Elzee-Studios/WRO-2026-Future-Engineers/vehicle-photos/Left.jpg

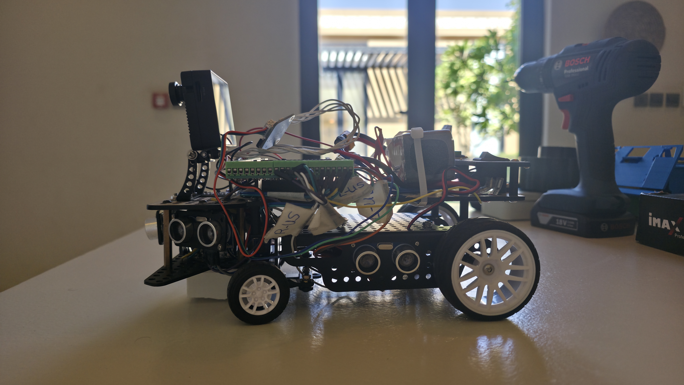
vehicle-photos/Left.jpg
