Elzee-Studios/WRO-2026-Future-Engineers/team-photos/Team-Photo-One.jpg

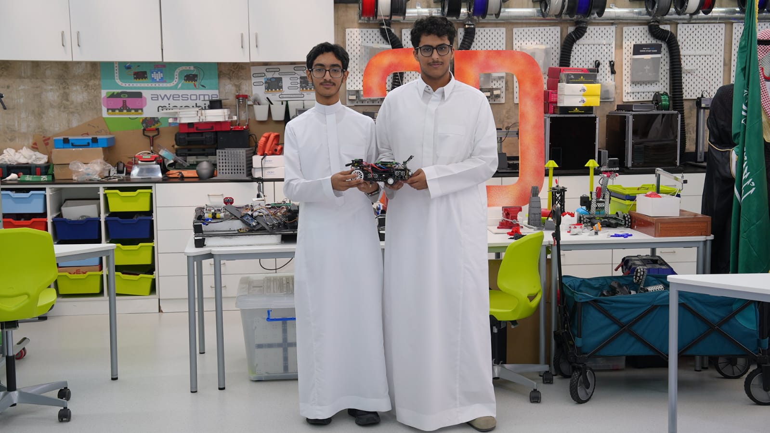
team-photos/Team-Photo-One.jpg
