Elzee-Studios/WRO-2026-Future-Engineers/team-photos/Team-Photo-Three.jpg

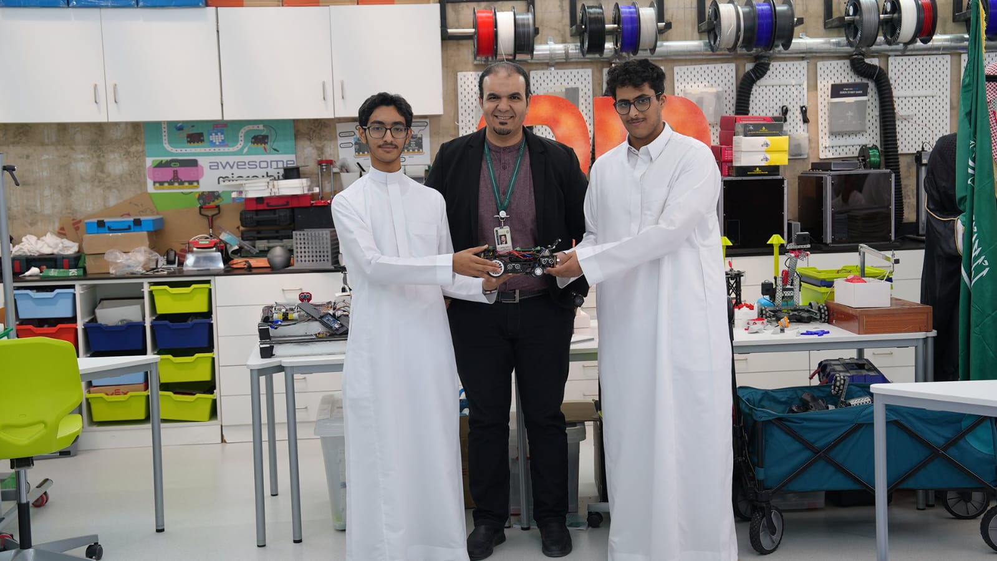
team-photos/Team-Photo-Three.jpg
