Elzee-Studios/WRO-2026-Future-Engineers/team-photos/Team-Photo-Two.jpg

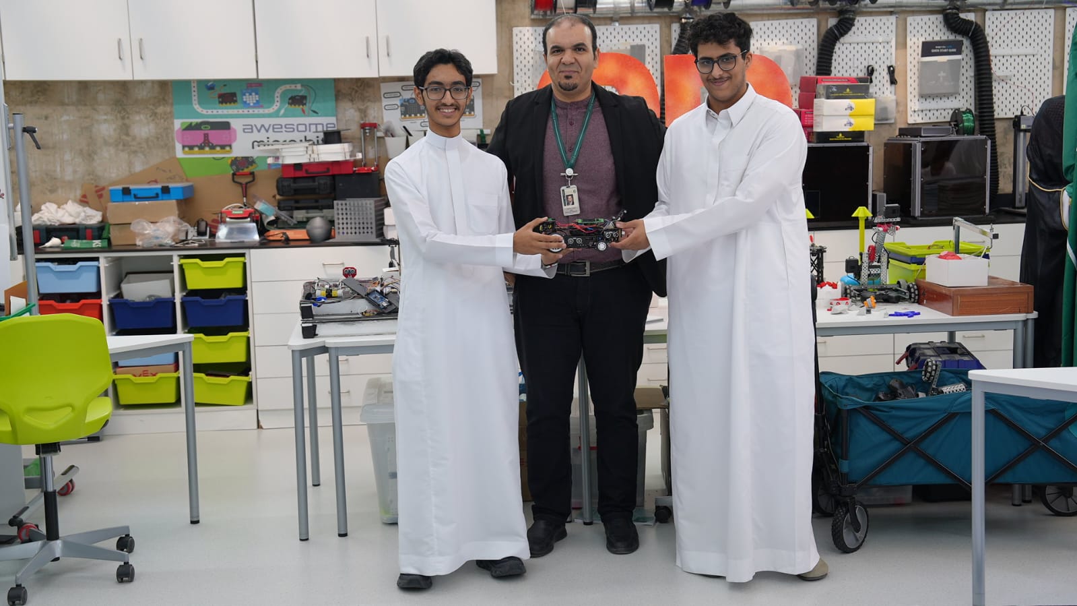
team-photos/Team-Photo-Two.jpg
