Elzee-Studios/WRO-2026-Future-Engineers/vehicle-photos/Bottom.jpg

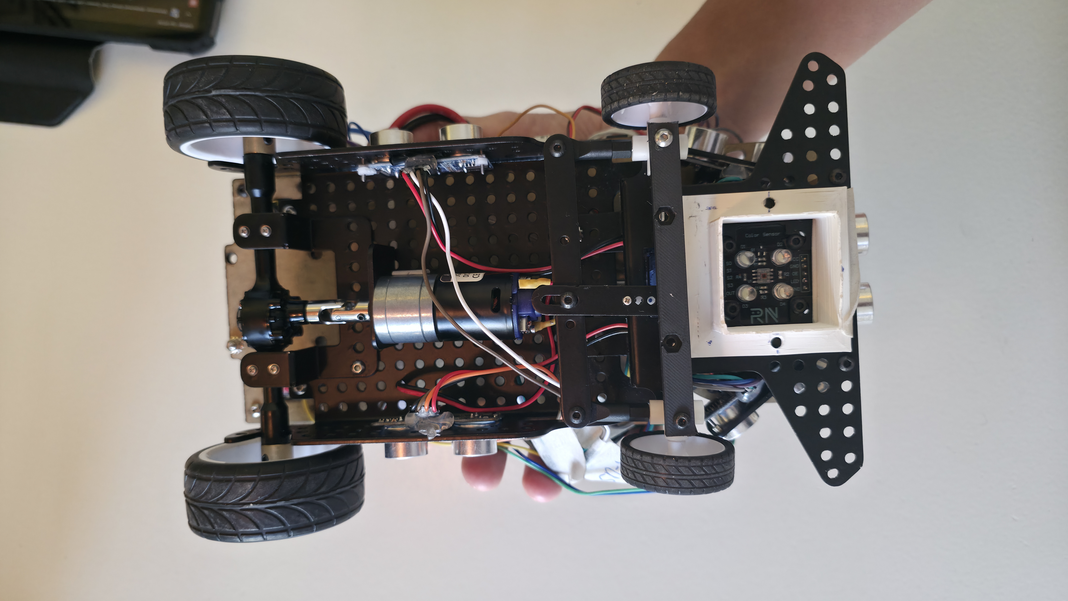
vehicle-photos/Bottom.jpg
