Elzee-Studios/WRO-2026-Future-Engineers/vehicle-photos/Front.jpg

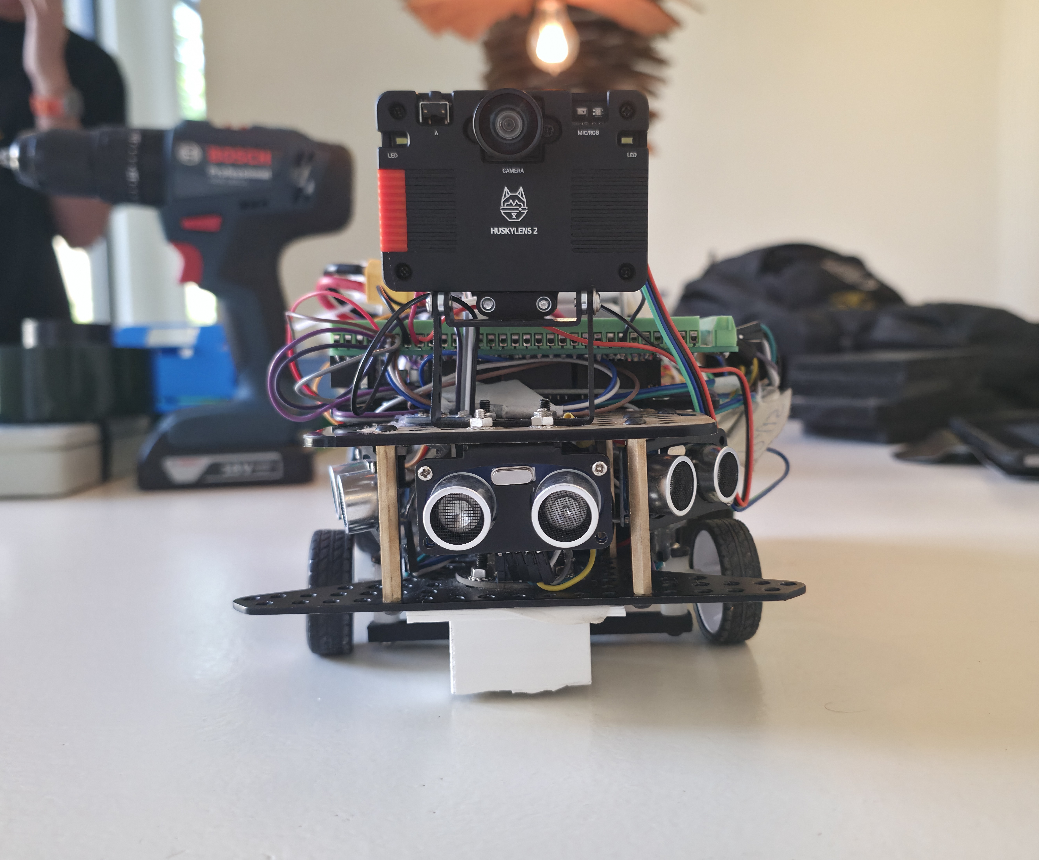
vehicle-photos/Front.jpg
