Elzee-Studios/WRO-2026-Future-Engineers/vehicle-photos/Rear.jpg

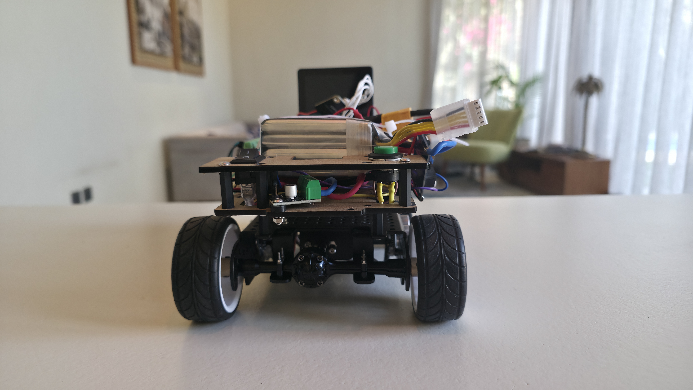
vehicle-photos/Rear.jpg
