Elzee-Studios/WRO-2026-Future-Engineers/vehicle-photos/Right.jpg

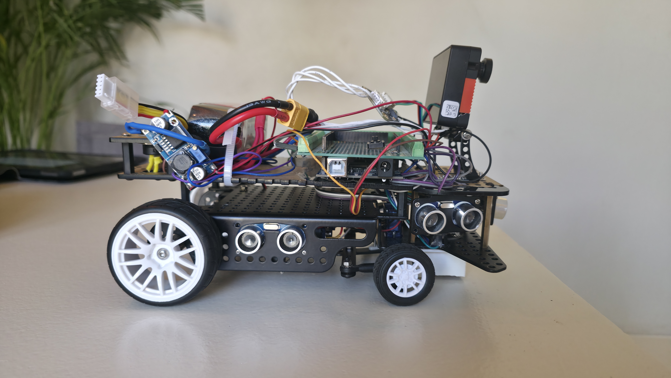
vehicle-photos/Right.jpg
