Elzee-Studios/WRO-2026-Future-Engineers/vehicle-photos/Top.jpg

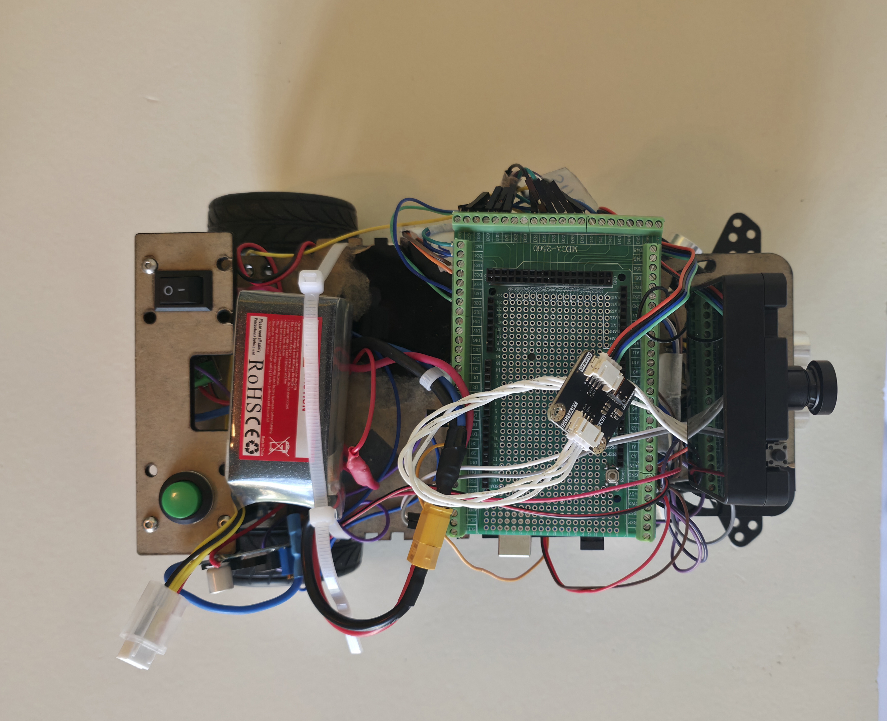
vehicle-photos/Top.jpg
