Elzee-Studios/WRO-2026-Future-Engineers/(commit log)

2026-09-15 Remove unused CAD models section
2026-09-22 Update bill of materials with new components
2026-10-18 Revise mobility design and update specifications
    Updated vehicle specifications and drive system details. Improved clarity on steering commands and testing iterations.
2026-10-18 Revise power and sensor architecture details
    Updated the power and sensor architecture documentation to reflect changes in components and their connections, including the introduction of the DRV8871 motor driver and HuskyLens 2.
2026-10-18 Revise systems thinking and engineering decisions document
    Updated vehicle dimensions, power decisions, navigation, and testing sections. Improved clarity and added details on risks and integration lessons.
2026-10-18 Revise reproducibility documentation for Arduino setup
    Updated wiring instructions, power connections, and software requirements for the Arduino Mega setup. Added details about color sensor calibration and challenge configurations.
2026-10-18 Revise bill of materials with new components
    Updated the bill of materials with additional components and specifications.
